zbanks/radiance_controller/README.md

Radiance Controller
===================

https://github.com/zbanks/radiance
