zbanks/radiance_controller/hardware/radiance_controller_v1_back.png

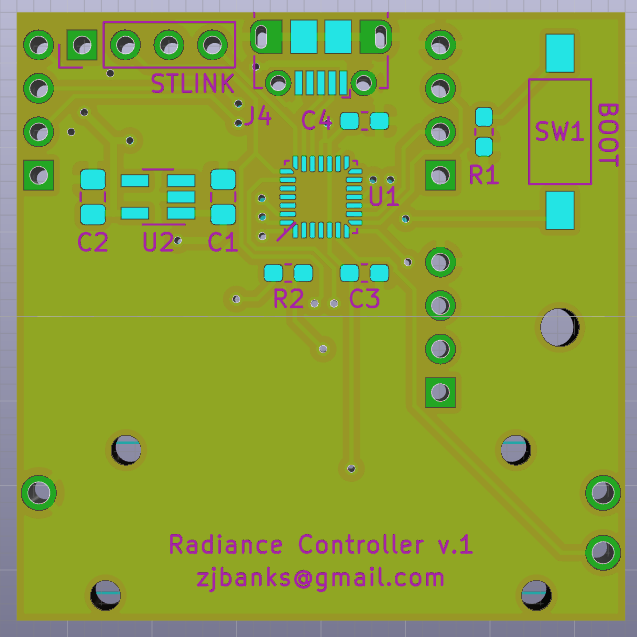
hardware/radiance_controller_v1_back.png
