zbanks/radiance_controller/hardware/radiance_controller_v1_front.png

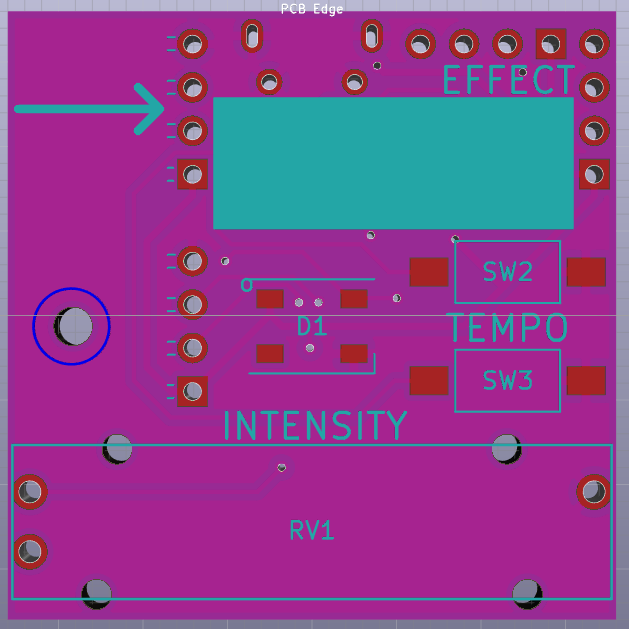
hardware/radiance_controller_v1_front.png
