zbanks/radiance_controller/hardware/radiance_controller_v1.pdf

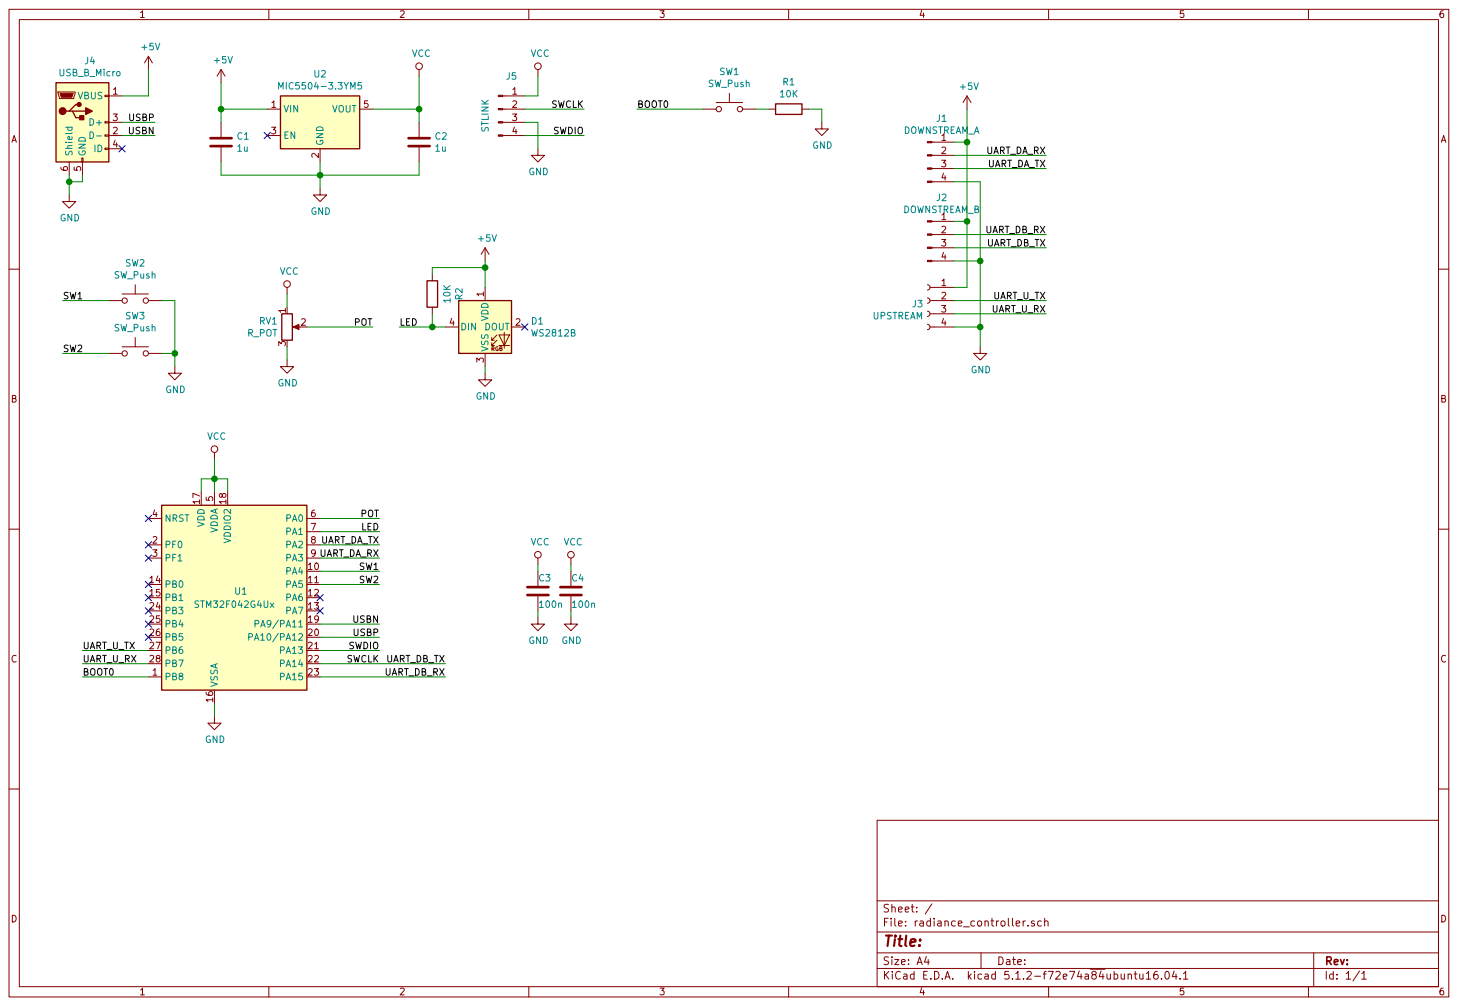
[picture p3: page 1]

File: radiance_controller.sch Sheet: / GND
