zbanks/radiance_controller/hardware/radiance_controller.kicad_pcb

## KiCad design hardware/radiance_controller.kicad_pcb (2019-08-18)

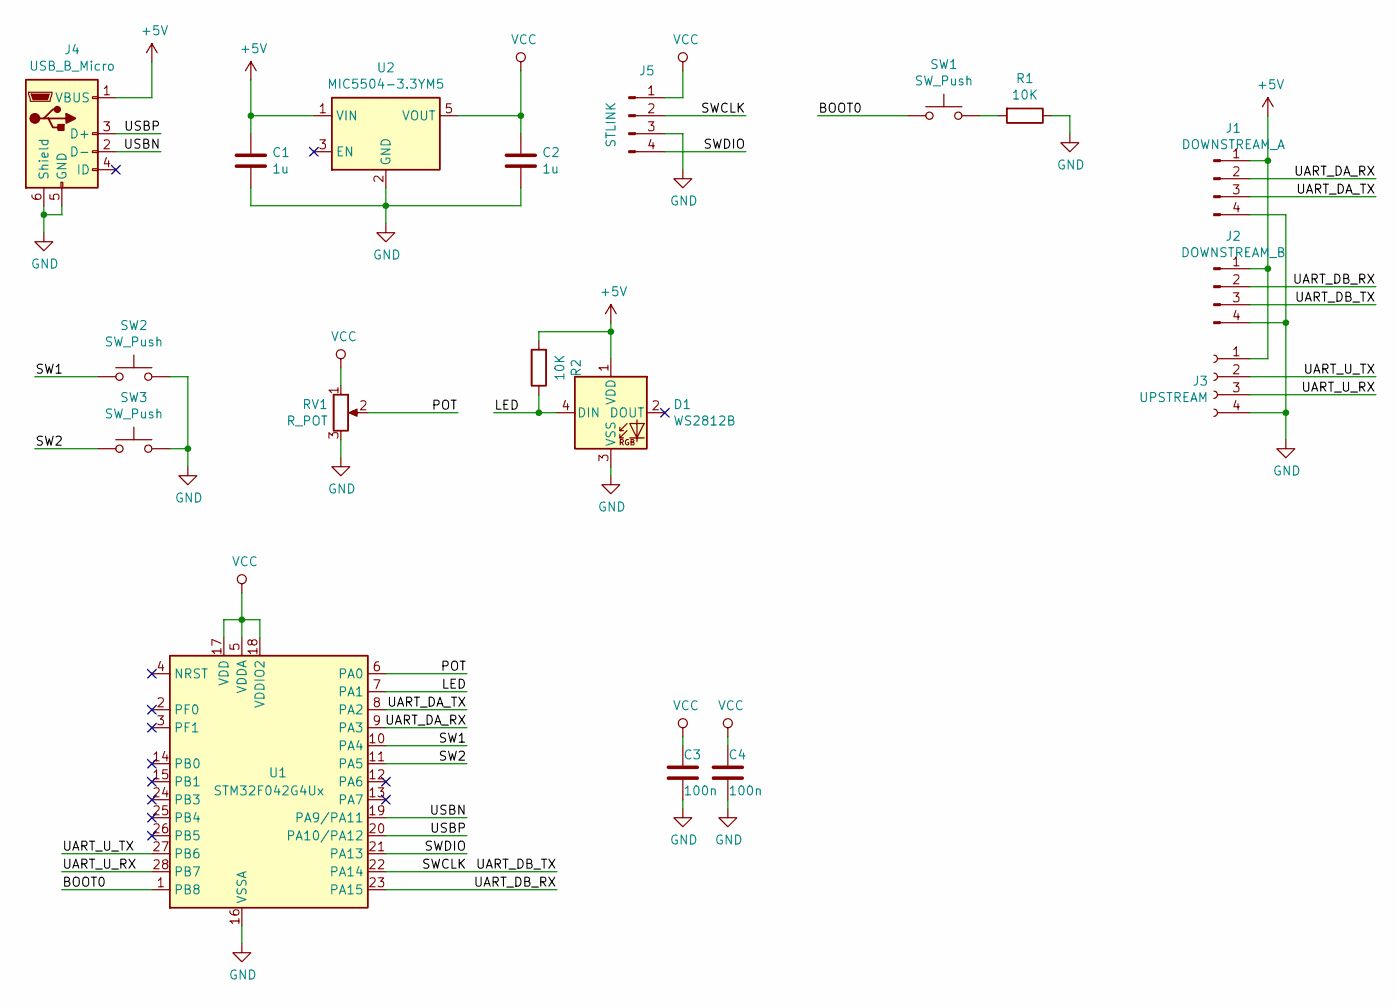
[picture p4: schematic radiance_controller.sch]

Parts:
C1, C2: 1u; C_0805_2012Metric_Pad1.15x1.40mm_HandSolder
C3, C4: 100n; C_0603_1608Metric_Pad1.05x0.95mm_HandSolder
D1: WS2812B; LED_WS2812B_PLCC4_5.0x5.0mm_P3.2mm
J1: DOWNSTREAM_A; PinHeader_1x04_P2.54mm_Horizontal
J2: DOWNSTREAM_B; PinHeader_1x04_P2.54mm_Horizontal
J3: UPSTREAM; PinSocket_1x04_P2.54mm_Horizontal
J4: USB_B_Micro; USB_Micro-B_Molex-105017-0001
J5: STLINK; PinHeader_1x04_P2.54mm_Vertical
R1, R2: 10K; R_0603_1608Metric_Pad1.05x0.95mm_HandSolder
RV1: R_POT; PTA2043
SW1, SW2, SW3: SW_Push; SW_SPST_FSMSM
U1: STM32F042G4Ux; QFN-28_4x4mm_P0.5mm
U2: MIC5504-3.3YM5; SOT-23-5_HandSoldering

Connections:
+5V: C1.1, D1.1 (VDD), J1.1, J2.1, J3.1, J4.1 (VBUS), R2.2, U2.1 (VIN)
/BOOT0: SW1.1, U1.1 (PB8)
/LED: D1.4 (DIN), R2.1, U1.7 (PA1)
/POT: RV1.2, U1.6 (PA0)
/SW1: SW2.1, U1.10 (PA4)
/SW2: SW3.1, U1.11 (PA5)
/SWCLK: J2.3, J5.2, U1.22 (PA14); also elsewhere on the board
/SWDIO: J5.4, U1.21 (PA13); also elsewhere on the board
/UART_DA_RX: J1.2, U1.9 (PA3)
/UART_DA_TX: J1.3, U1.8 (PA2)
/UART_DB_RX: J2.2, U1.23 (PA15)
/UART_U_RX: J3.3, U1.28 (PB7)
/UART_U_TX: J3.2, U1.27 (PB6)
/USBN: J4.2 (D-), U1.19 (PA9/PA11)
/USBP: J4.3 (D+), U1.20 (PA10/PA12)
GND: C1.2, C2.2, C3.2, C4.2, D1.3 (VSS), J1.4, J2.4, J3.4, J4.5 (GND), J4.6 (Shield), J5.3, R1.1, RV1.3, SW2.2, SW3.2, U1.16 (VSSA), U2.2 (GND); also elsewhere on the board
unnamed: R1.2, SW1.2
VCC: C2.1, C3.1, C4.1, J5.1, RV1.1, U1.5 (VDDA), U1.17 (VDD), U1.18 (VDDIO2), U2.5 (VOUT); also elsewhere on the board

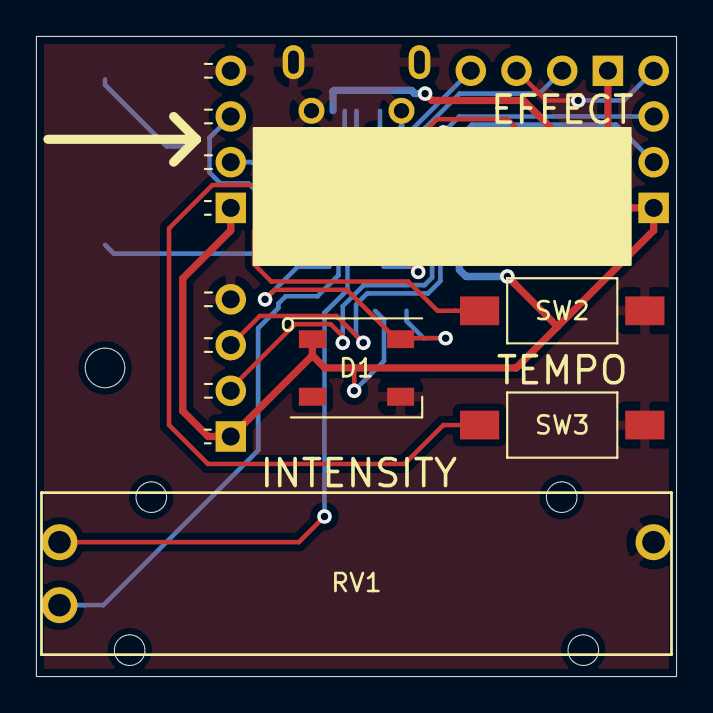
[picture p5: board radiance_controller.kicad_pcb from above]

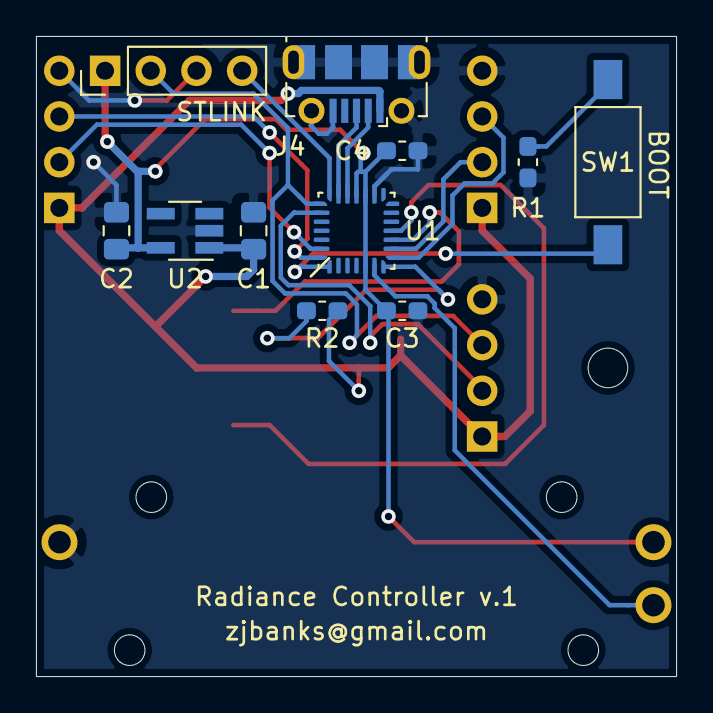
[picture p6: board radiance_controller.kicad_pcb from below]

Board: 2 copper layers, 35.6 x 35.6 mm, 18 parts (11 on the bottom side), 18 nets.

Other parts of the board:
STLINK: STLINK; PinHeader_1x04_P2.54mm_Vertical

Their connections:
/SWCLK: STLINK.2; also elsewhere on the board
/SWDIO: STLINK.4; also elsewhere on the board
GND: STLINK.3; also elsewhere on the board
VCC: STLINK.1; also elsewhere on the board
