zbanks/radiance_controller/(commit log)

2019-07-28 LED sort of works
2019-07-28 Clean up some known garbage around LED
2019-07-28 Clean up LED stuff more now that it reliably works
2019-08-18 Duplex communication working
    [radiance_controller.kicad_pcb]
